FlyRay2025-gif/stm32-env-thermometer/docs/实验方案（实施版）.md

# 基于单片机的环境温度测量仪 —— 实验方案与实施（实施版）

**项目名称：基于单片机的环境温度测量仪设计与制作**
**项目性质：校级开放性实验室项目（2026-09-01 ～ 2026-11-01）**
**成果形式：实物作品 + 结题报告**
**文档版本：V1.1（2026-10-10 按实际实施情况修订）｜本公开版已脱敏、仅保留技术内容**

*项目主要内容：为解决传统温度测量响应迟缓、精度不足等弊端，设计以32系列单片机为核心控制器，结合DS18B20、LM35等温度传感器及液晶显示、报警、按键设置等模块，通过C语言编写程序并优化数据精度，完成环境温度测量仪的设计与制作，实现环境温度的精准采集、实时显示、阈值报警，测量仪结构精简、成本可控*

***

## 0. 一页纸摘要

| 项 | 结论 |
| --- | --- |
| 主控 | **STM32F103C8T6**（ARM Cortex-M3，72 MHz，64 KB Flash / 20 KB RAM，LQFP-48 最小系统板"Blue Pill"） |
| 开发路线 | **Keil MDK5 + STM32F10x 标准外设库 V3.5.0**，同型号板卡、同库，教程例程（按键/串口/TIM-PWM/ADC+DMA/OLED/AT24C01/单总线 DS18B20）可直接复用 —— 这是 2 个月工期的主要保障（详见 5.0） |
| 数字温度通道 | **DS18B20**（1-Wire，12 位，0.0625 ℃ 分辨率）×1 只（模块版，板载 4.7 k 上拉） |
| 模拟温度通道 | **LM35DZ**（TO-92，10 mV/℃）**直接采样**：OUT→R9 100 Ω→PA4（无运放、无 C3）→ 片内 12 位 ADC |
| 显示 | **0.96″ OLED SSD1306（I²C，地址 0x3C）**；若老师要求"液晶"字样，直接换 **LCD1602A + PCF8574T（I²C 0x27）**，引脚不变 |
| 报警 | **3 针蜂鸣器模块**（VCC/GND/IO，自带驱动，TIM3 PWM）+ 红色 LED，单阈值、带回差 |
| 按键 | 3 × 6×6 轻触开关（SET / ＋ / －） |
| 参数存储 | **未安装**（AT24C02 预留未用；阈值仅存 RAM，断电回 30.0 ℃） |
| 上位机 | 板载 CH340（USART1，115200）输出 CSV，Excel 直接画图；可选 JY-89S 蓝牙 |
| 关键精度指标 | 分辨率 0.01 ℃（DS18B20）/ 0.1 ℃（LM35）；测温范围 **0～+80 ℃**（LM35 直采硬件 0～+100 ℃，负温段不可测）；综合精度目标 ≤ ±0.5 ℃（以结题实测为准）；采样周期 ≤1 s；报警响应 <2 s；连续运行 ≥48 h（拷机待做） |
| 精度优化手段（本版已实现） | ① DS18B20：上电预填充 5 点缓冲 + **5 点滑动平均**；② LM35：**16 次采样平均** + 239.5 周期长采样；③ DS18B20 **CRC8 校验**、报警 0.5 ℃ 回差；④ 后续可加：VREFINT 校正、过采样、软件标定（见 5.4） |
| 硬件实现路径 | **面包板整机一步到位（免焊接）**；立创 EDA 原理图仅作报告插图，不打样、不焊接 |
| 成本 | 全部器件自费，整机物料成本在 200 元以内（以实际采购为准） |
| 最大风险 | **面包板接触不良**（已实际发生：OLED 黑屏、电阻虚接、LM35 假读数）→ 免仪表排故法见第 9 节；交付前避免搬动整机 |

> **实施变更摘要（2026-10-10，V1.1）**——本版按最终实物修订，与 V1.0 的主要差异：
> 1. **搭建路线：全程面包板，免焊接**。放弃洞洞板 + 排母与立创 PCB 打样——操作简便、迭代快；团队成员焊接经验生疏，避免焊接返工拖期；验收不要求 PCB。
> 2. **模拟通道：取消 MCP6002 运放调理，LM35 直接采样进 PA4**（1→5V、3→GND、2→R9 100 Ω→PA4）。到货的 MCP6002 为 SOIC-8 贴片封装，无法直插面包板；直采链路更短、误差源与故障点更少。代价：**0 ℃ 以下无法测量**（单电源无偏置）。
> 3. **C3 100 nF 抗混叠电容未安装**（可选件，实测读数稳定；若出现抖动可加回 PA4↔GND）。
> 4. **单只 DS18B20**；蜂鸣器改 **3 针模块**（自带驱动，无 S8050）；按键 **3 个**（SET/＋/－）；**AT24C02 未安装**（阈值仅存 RAM，断电回 30.0 ℃）。
> 5. **供电与调试：USB 供电（5 V + CH340），ST-Link 仅接 SWDIO/SWCLK/GND**。
> 6. 固件按直采公式 `T = V / 0.01` 换算；DS18B20 5 点滑动平均、LM35 16 次采样平均；VREFINT 校正、软件标定与 EEPROM 存储未实施（列为后续优化）。

***

## 1. 项目概述与设计目标

### 1.1 选题要求拆解（对照项目"主要内容"）

| 选题原文要求 | 本方案落实 | 章节 |
| --- | --- | --- |
| 以 32 系列单片机为核心控制器 | STM32F103C8T6 | 3、4、5 |
| 结合 DS18B20、LM35 等温度传感器 | 双通道：DS18B20 数字通道 + LM35 模拟通道，互为校核 | 4.2、4.3 |
| 液晶显示 | SSD1306 OLED（默认）/ LCD1602（可选替换，同一 I²C 总线） | 4.4 |
| 报警 | 3 针蜂鸣器模块 + LED，单阈值报警、可设、带回差 | 4.6 |
| 按键设置 | 3 键（SET/＋/－）阈值设置 | 4.5 |
| C 语言编写程序并优化数据精度 | 5 点滑动平均 + 16 次采样平均 + CRC 校验与报警回差 | 5、6 |
| 环境温度精准采集、实时显示、阈值报警 | 约 1 s 采样/刷新、<2 s 报警 | 1.2 |
| 结构精简、成本可控 | 单 5 V 输入、板上 3.3 V、总器件 ≤ 25 种、整机 ≤ 220 元（全部自费） | 3、8 |

### 1.2 量化验收指标（结题时按此逐项演示/举证）

| 编号  | 指标 | 目标值 | 验证方法 |
| --- | --- | --- | --- |
| M1  | 测温范围 | **0 ～ +80 ℃**（原目标 −10～+80 ℃；本版直采无负温段，硬件 0～+100 ℃） | 冰水混合物 + 恒温热水浴（实验室直流稳压电源+电热杯） |
| M2  | 显示分辨率 | 0.01 ℃（DS18B20 通道）/ 0.1 ℃（LM35 通道） | 读数末位观察 + 串口 CSV |
| M3  | 综合精度 | **≤ ±0.5 ℃**（−10～+60 ℃，两点标定后） | 与标准水银温度计（实验室借用）5 点对比 |
| M4  | 重复性（稳定性） | 恒温点 σ ≤ 0.1 ℃（30 min，1 Hz 采样） | 冰水浴静置 30 min，Excel 求标准差 |
| M5  | 双通道一致性 | 未标定偏差 ≤ 1.0 ℃，标定后 ≤ 0.3 ℃ | 两探头并扎同置 |
| M6  | 采样与刷新 | 采样周期 ≤1 s，显示刷新 ≥2 Hz 不卡顿 | 秒表 + 串口时间戳 |
| M7  | 报警功能 | 越限 <2 s 动作，回差 0.5 ℃ 不误报，消音有效 | 设定阈值后温度阶跃 |
| M8  | 掉电保持 | 阈值/标定系数断电 10 次不丢失 | 拔电重启核对 |
| M9  | 连续运行 | ≥48 h 拷机无死机、无复位、无显示异常 | 串口日志计数 |
| M10 | 抗电源扰动 | VDDA 在 4.5～5.5 V 变化时读数漂移 ≤ 0.2 ℃ | 实验室直流稳压电源调压 + 示波器监测 |
| M11 | 探头故障自检 | 拔下 DS18B20 后 1 s 内显示 `ERR` 并自动切换 LM35 通道 | 拔插演示 |
| M12 | **响应时间（直接回应选题"响应迟缓"痛点）** | 裸探头 t63 ≤ 10 s；带探头护套 t63 ≤ 25 s；同时给出 DS18B20 与 LM35 两通道对比 | 阶跃法：两探头并扎，从室温迅速移入冰水，串口 20 Hz 记录，Excel/serialplot 求 63% 到达时间 |

> **注 1**：M3 与 M10 是答辩最能拉开差距的两条，务必留原始数据。
> **注 2**：M12 是选题"为解决传统温度测量响应**迟缓**、精度**不足**等弊端"中"响应迟缓"四项字要求里唯一需要**动态测试**的指标，务必与 M3 一起留图（阶跃曲线 + 标定散点＝报告两张核心图）。

> **实施版逐条状态（2026-10-10）**：M1 → 实际 0～+80 ℃（负温段不具备）；M2 已实现；M3 → 以结题实测比对为准（本版无软件标定）；M4 → 待测；M5 → 待测（两探头并扎）；M6 → 约 1 Hz 刷新（原目标 ≥2 Hz，实际为 1 s 一轮）；M7 已实现（0.5 ℃ 回差）；**M8 → 不适用**（未装 AT24C02，阈值断电回 30.0 ℃，作为已知限制）；M9 → 拷机待做；M10 → 不适用（USB 供电，无调压条件）；**M11 → 部分**（拔探头显示 DS18B20 ERROR，无自动切换）；M12 → 待测。

***

## 2. 方案论证（为什么这样选）

### 2.1 主控三条路线对比

| 路线 | 代表 | 优点 | 缺点 | 结论 |
| --- | --- | --- | --- | --- |
| A：8 位 | STC89C52 / STC12C5A60S2  | 资料最多、上手最快 | 无 12 位 ADC（LM35 需外挂 ADS1115）、无硬件 I²C 需软件模拟、精度上限低 | 否（与"32 系列"要求不符） |
| B：32 位国产 | CH32V003 / CKS32F103C8T6 | 便宜 | 生态与教程少，ADC 一致性资料不足 | 否（作为 B 计划备用） |
| **C：STM32F103C8T6** | 通用 Blue Pill | 内置 12 位 ADC + 温度传感器 + VREFINT + 硬件 I²C/USART/TIM；**（同型号板 + Keil MDK + 标准外设库），单总线 DS18B20、OLED、AT24C01、ADC、TIM-PWM、串口例程可逐章直接复用**；实验室示波器/仿真器通用 | 引脚多、需理解时钟树；标准库需自己配置寄存器（教程已覆盖） | **采用** | | | | |

**采用理由（写进报告）**：① 满足"32 系列"要求；② 片内 12 位 ADC 与 VREFINT 自检通道，使 LM35 通道无需外置 ADC，符合"结构精简、成本可控"；③ 团队正按（Keil MDK + 标准外设库）学习同一型号芯片，**开发路线零切换成本**，2 个月内可完成。

### 2.2 双传感器通道的必要性（本项目立论核心）

| 对比项  | DS18B20（数字） | LM35（模拟） |
| ---- | --- | --- |
| 接口 | 1-Wire，占用 1 个 GPIO | 需 ADC（本版直连，无调理） |
| 分辨率  | 0.0625 ℃（12 位，可设 9～12 位） | 受 ADC 分辨率限制（约 0.08 ℃/LSB） |
| 精度 | ±0.5 ℃（−10～+85 ℃） | ±0.5 ℃（+25 ℃ 典型），需标定 |
| 转换时间 | 12 位 750 ms | 即时（可 1 kS/s） |
| 优点 | 免标定、抗干扰、可多点总线 | 响应快、可高频采样、验证模拟链路设计能力 |
| 缺点 | 慢、假货多 | 量程受单电源限制（0 ℃ 以下不可测） |

→ **两路互为校核 + 故障切换**，正好把"优化数据精度"做成有对比、有数据、有图表的结题亮点。

**外部实测佐证（开源调研 2026-09-02，详见附录 D）**：

* **精度目标可达成**：`Cyclohexi/STM32-Smart-Thermometer`（MIT）在同型号 F103C8T6 + SSD1306 上，仅用**两点线性校准**即实测残差 **RMS ≈ 0.5 ℃** → 本方案 M3 的 ±0.5 ℃ 不是拍脑袋指标。本版以 **16 次采样平均 + 5 点滑动平均**实现基础降噪（VREFINT 反算、64 次过采样与多点最小二乘标定列为后续优化），指标仍保守写 ±0.5 ℃，避免答辩时被单点数据反问。

* **响应时间必须量化**：`Santocoyo/Comparison-of-sensitivity-of-temperature-sensors-LM35-and-DS18B20`（MIT）用**空气 / 冷水 / 热水三种介质的阶跃对比**证明 LM35 明显快于 DS18B20 —— 这正是选题要求中"响应迟缓"痛点的实测形态。故新增 **M12 响应时间**指标（见 1.2）与阶跃测试步骤（见 6.1 步 10），并把"两通道 t63 对比曲线"作为报告核心图之一。

### 2.3 系统框图

```
                         ┌────────────────────────────────────────────┐
   USB 5V ──────────────►│  Blue Pill：AMS1117-3.3 → 3.3V             │
   （供电 + 串口）         └───────────┬────────────────────────────────┘
                                     │
   ┌───────────┐  1-Wire(PA1)        │  STM32F103C8T6
   │ DS18B20×1 │─────────────────────►│  ┌────────────────────┐
   └───────────┘  （上拉在模块上）      │  │ 主循环 ~0.8 s 一轮  │
                       ┌───────────┐  │  │ 采样/滤波/报警/显示  │
   环境温场 ──────────►│  LM35DZ   │  │  └────────────────────┘
                       └─────┬─────┘  │
                             │10mV/℃  │
                    R9 100Ω  │         │
                       ┌─────▼─────┐   │
                       │  PA4/IN4  │───┘
                       └───────────┘

   其余：I²C1(PB6/PB7) → SSD1306 OLED 0x3C ｜ PB12/13/14 → 3 按键
         PA6 → 3 针蜂鸣器模块 ｜ PA7 → 报警 LED ｜ PC13 → 心跳灯
         USART1(PA9/PA10) → 板载 CH340 → PC ｜ SWD(PA13/PA14) → ST-Link（仅下载）
```

***

## 3. 器件选型清单（BOM，全部到型号）

### 3.1 核心器件

| &#x23; | 位号 | 型号 / 规格 | 封装 | 数量 | 参考单价(元) | 采购渠道 | 备注 / 替代料 | 套件 |
| --- | --- | --- | --- | -- | --- | --- | --- | ---- |
| 1 | U1 | **STM32F103C8T6** 最小系统板（Blue Pill，含 AMS1117-3.3、板载 CH340G/CP2102、复位与 8M 晶振） | LQFP48 板 | 1 | 15～22 | 淘宝"STM32F103C8T6 最小系统板" | 正点原子 Mini STM32（¥69，资料更全）；芯片若为 **CKS32F103C8T6（国产兼容）** 功能可用，但需在报告中如实注明。**若团队已有 ST-Link 可省；若担心调试中烧坏可加购 1 块备用（+15～22 元）** | ✓ |
| 2 | U2 | **DS18B20**（建议买 **模块版：板载 4.7 k 上拉 + 3P 排针**） | TO-92 / 模块 | 1（模块版） | 2～5 | 淘宝/立创商城 | 关键：**认准原装或立创商城自营**，假货实测偏差可达 1～2 ℃；替代 **DS18B20+（带 -40~125 更宽）** | |
| 3 | U3 | **LM35DZ/NOPB**（TI，TO-92，±0.5 @+25 ℃，10 mV/℃，4～30 V 供电） | TO-92 | 1 | 8～14 | **立创商城有现货**（LM35DZ/NOPB） | 若涨价/缺货：换 **LM35AZ** 或 **MF58 10 k B3950 NTC + 分压**（需重做标定，方案 4.3 电阻值另算） | |
| 4 | U4（未采用） | **MCP6002**（原计划运放调理） | SOIC-8 | 0 | 3～5 | 立创商城 | **本版未采用**：到货为 SOIC-8 无法直插面包板，模拟通道改直采（见 4.3） | |
| 5 | D1 | **0.96″ OLED SSD1306 128×64 I²C 4Pin** | 模块 | 1 | 12～16 | 淘宝 | 若需"液晶"：换 **LCD1602A + PCF8574T 转接板**（¥10，I²C 地址 0x27） | ✓ |
| 6 | U5（未安装） | **AT24C02** 模块（A0A1A2 接地 → 0x50） | 模块/SOIC | 1  | 2～4 | 淘宝/立创  | 亦可用 STM32 片内 Flash 模拟；**本版未安装、固件未含驱动**（阈值仅存 RAM） | |
| 7 | LS1 | **3 针蜂鸣器模块**（VCC/GND/IO，自带驱动；原计划为裸无源蜂鸣器） | 模块 | 1 | 1～3 | 淘宝/立创 | **本版实际使用 3 针模块**：无需 S8050 与基极电阻，IO 直连 PA6（2 kHz PWM 触发） | ✓ |
| 8 | Q1（未采用） | ~~S8050 三极管~~（原计划蜂鸣器驱动） | TO-92 | 0 | 0.1 | — | **本版未使用**：蜂鸣器为 3 针模块，自带驱动 | |
| 9 | SW1-3  | 轻触开关 6×6×5 mm 四脚 | 直插 | 3 | 0.1 | 元件包 | 本版使用 3 键（SET/＋/－） | ✓ |
| 10 | LED1-2 | 红色/绿色 3 mm LED | 直插 | 3  | 0.1 | 元件包 | — | ✓ |
| 11 | X1 | **8.000 MHz 无源晶振 HC-49S**（最小系统板已焊） | — | — | — | — | 教程模板默认用板载 HSE×9=72 MHz，无需改动；**若怀疑晶振不起振（上电卡死在时钟就绪等待），临时把 PLL 源改 HSI 降频验证**（见 5.1 降级手段） | |

> **实施版 BOM 说明**：本版实际使用 U1、DS18B20 模块×1、LM35DZ×1、OLED、3 针蜂鸣器模块、3 按键、LED、R9 100 Ω、杜邦线、830 孔面包板；U4/U5/Q1、排母、洞洞板、PCB、外壳等未采购或未使用。

### 3.2 阻容与结构件

| &#x23; | 名称 | 规格 | 数量 | 参考单价 | 套件 |
| --- | --- | --- | ----- | --- | ---- |
| 12 | 电阻 | 0805/1/4W 直插：4.7 k×10、10 k×20、30 k×6、15 k×4、1 k×10、100 Ω×6 | 各若干 | 元件包 ¥8 | |
| 13 | 电容 | 100 nF 瓷片×20、10 µF/25 V×10、1 µF×6、22 pF（板载） | 各若干 | 元件包 ¥8 | |
| 14 | 排针/排母 | 2.54 mm 单排 1×40 | 各 4 条 | ¥6 | 部分✓（套件含面包板跳线） |
| 15 | 杜邦线 | 母对母 20 cm ×40 | 1 排 | ¥5 | ✓ |
| 16 | 万能板/洞洞板 | 7×9 cm 单面 | 1 | ¥6 | |
| 17 | 面包板 | 830 孔 | 1 | ¥8 | ✓ |
| 18 | PCB | 立创 EDA 双层 10×10 cm 内，5 片 | 1 单 | **¥0（嘉立创 2026 年每月 2 张免费打样券，≤10×10 cm、最多 4 层、含运费，须通过 DRC、勿拼板）** | |
| 19 | 外壳 | 塑料仪表盒 120×80×45 mm 或 亚克力激光切割 | 1 | ¥15～35（可用 3D 打印/硬纸板/亚克力边角料替代，或直接裸板交付） | |
| 20 | 电源 | 5 V/2 A USB 电源适配器；或 18650 电池盒 + MT3608 升压（便携演示用） | 1 | ¥15～25（可用笔记本 USB 口供电，无需另购） | |
| 21 | 开关/保险 | 船型开关、500 mA 自恢复保险丝 | 各 1 | ¥3 | |
| 22 | 其他 | 排线、铜柱、杜邦头、热缩管、锡丝、助焊剂 | — | ¥20 | |

> **实施版**：实际只用 R9 100 Ω×1 与杜邦线/面包板；其余阻容（10k/30k/15k 等）与结构件未使用，焊接耗材未用。

### 3.3 工具与借用设备（不采购）

| 设备 | 用途 | 来源 |
| --- | --- | --- |
| ST-Link V2（或 J-Link OB） | 下载 + 在线调试 + DWT 微秒延时 | **套件已含**（三人共用，无需另购） |
| 数字示波器（≥50 MHz） | 观测 1-Wire 时序、I²C 波形、ADC 输入纹波、VDDA 稳定性 | **实验室开放实验条件**，预约使用 |
| 直流稳压电源 | 4.5～5.5 V 调压做电源调整率测试（M10） | 实验室 |
| 信号发生器 | 输出 0～1.5 V 精密直流/缓变斜坡，替代 LM35 标定 ADC 链路线性度 | 实验室 |
| 标准水银温度计 / 高精度数显温度计 | 标定与对比基准（M3） | 实验室借用（或自购 ¥25） |
| 万用表、电烙铁（可调温）、吸锡带、放大镜 | 焊接与排查 | 实验室 |

***

## 4. 硬件设计（到引脚、到电阻值）

### 4.1 主控最小系统 U1

* 直接用最小系统板：板上已含 STM32F103C8T6、8 MHz HSE、AMS1117-3.3、复位电路、BOOT0/BOOT1 跳线、板载 USB-TTL（CH340G，接 PA9/PA10）与 micro-USB。

* **上电前必查**：BOOT0 跳线接 GND（从 Flash 启动）。Blue Pill 常见"焊反 BOOT 排针导致无法启动"。

* **VDDA 处理**：板上 VDDA 与 VDD 已内部相连；额外在 VDDA 引脚附近加 **100 nF + 1 µF + 10 µF** 去耦（LM35 通道精度依赖它）。

* **PC13 心跳灯**：本版实际用 PC13 板载 LED 作 1 Hz 心跳指示，所用批次驱动正常；若遇驱动弱/闪烁异常，可改 PB0 外接 LED。

### 4.2 DS18B20 数字温度通道（1-Wire）

```
        3.3V ─────┬────── R1 4.7kΩ ──┐ (上拉，紧贴 DS18B20 端)
                  │                  │
   VDD(左)  ──────┘                  ├────── PA1 (GPIO 开漏/内部上拉)
   DQ (中)  ─────────────────────────┘        │
   GND(右)  ────── GND ───────────────────────┴──── GND
        │
   DS18B20 TO-92（字面朝自己，引脚从左至右：GND / DQ / VDD）
   ※ 若买模块版：模块上已有 4.7k 上拉，直接接 VCC/DQ/GND 三线
```

* **本版只装 1 只 DS18B20**（模块版，上拉在模块上）。驱动用 0xCC 跳过 ROM，仅支持单只；双探头冗余为后续扩展（需补 ROM 搜索/匹配）。

* 接线长度 ≤ 30 cm 用 4.7 kΩ；若探头延长到 1 m，上拉降到 **2.2 kΩ** 并用三芯线（VDD/GND/DQ），**严禁寄生供电**（VDD 悬空会导致 −7 ℃ 恒定读数）。

* 探头处加 **100 nF 到 GND**，长线串 **100 Ω**。

* **典型坑（写进报告的"调试记录"）**：

  1. 读到 `0x0550`（=85 ℃）→ 上电复位默认值，说明没做 Convert T，只读了暂存器；

  2. 读到 −7 ℃ / 恒定值 → 寄生供电或 VDD/GND 接反；

  3. 时序被中断打断 → 复位/写时隙必须**关中断 + 用 DWT 精确微秒延时**（教程 `Delay.c` 的 `Delay_us` 是按 72 MHz 标定的空循环，改优化等级或主频就会偏；且 SysTick 在 PRIMASK=1 时不计数 → 这是本项目最容易踩的坑）。

* **本版为阻塞式读取**：`StartConv` 后 `Delay_ms(760)` 再读暂存器（简单可靠，OLED 约 1 s 刷新一轮）；"非阻塞 + 期间刷新"列为后续优化。

* 每帧读 9 字节，做 **CRC8（多项式 x⁸+x⁵+x⁴+1，反射式 0x8C）** 校验，CRC 错则丢弃并计入错误率统计（报告可给"10 万帧 CRC 错误 0 次"的数据）。

### 4.3 LM35 直接采样通道（ADC1_IN4，本项目模拟通道）

**实际实施方案（V1.1）**：取消运放调理，LM35 输出经一只串联电阻直接进 ADC。

```
   LM35DZ（TO-92，平面朝自己、脚朝下：1 VCC / 2 OUT / 3 GND）
   1 ── 5V（USB 供电；LM35 需 4～30 V）
   3 ── GND
   2 ── R9 100 Ω ──┬── PA4（ADC1_IN4）
                   │
              （C3 100 nF 未装，可选）
```

* 换算：`T(℃) = V / 0.01`（10 mV/℃）；**0 ℃ 以下输出为负、单电源无法测量**，固件对负值按 0 处理。
* 量程：硬件 0～+100 ℃（ADC 0～1 V 段）；实际验收按 0～+80 ℃。
* 分辨率：3.3 V / 4095 ≈ **0.806 mV/LSB ≈ 0.08 ℃**；软件 **16 次采样平均**抑制噪声。
* 采样配置：ADC1_IN4，独立模式单次转换，**采样时间 239.5 cycles**（ADC 时钟 12 MHz，APB2/6）。
* 主要误差：LM35DZ 自身 ±0.5 ℃（25 ℃ 典型）、AMS1117 基准 ±1.5%（未做 VREFINT 校正）、面包板接触与走线干扰 → 结题以实测比对（冰水/室温/热水）为准。
* **为什么放弃运放（记录）**：原设计为 MCP6002 偏置放大（`Vout = 2·V_SEN + 0.4125 V`，可覆盖 −20～+135 ℃）。实际到货为 **SOIC-8 贴片封装**，无法直插面包板；且本版优先"操作简便、少一个故障点"，故改为直采。代价是失去负温段——M1 的 −10 ℃ 项实测不可达（测试手段也只有冰水/热水，产不出负温）。
* **备选方案（原设计，未实施，供后续 PCB/升级版参考）**：单级偏置同相放大，`Vout = 2.0·V_SEN + 0.4125 V`，`T = (Vout − 0.4125) / 0.02`。R3 15 k / R4 1 k 分压得 0.206 V 基准（U4A 跟随），R5 / R6 10 k 求和，U4B 增益 4（1 + R8 30 k / R7 10 k），R9 100 Ω + C3 100 nF 进 PA4。若后续换 PCB 或补直插运放，可恢复负温量程（接线见《B板模拟接线图》存档）。

### 4.4 显示模块 D1（SSD1306 I²C）

* 4 线：`VCC→3.3V`、`GND`、`SCL→PB6`、`SDA→PB7`。

* **总线方案：OLED 走教程的"软件模拟 I²C"驱动（PB6=SCL、PB7=SDA，GPIO 开漏/推挽 + 输入读）**。理由：① 教程 OLED 例程可直接复用；② STM32F103 硬件 I²C1 有已知 BUSY 位锁死 errata；③ 刷新量小，软 I²C 足够。AT24C02 本版未装。

* **I²C 上拉**：确认板上有 4.7～10 k 上拉；若无，PB6/PB7 各加 4.7 k 到 3.3 V（Blue Pill 多数批次无此上拉，**这是"屏幕不亮"的第一嫌疑**）。

* 地址：本版固定 **0x78（7 位 0x3C）**；0x3D 批次需改宏。

* 界面（128×64，分 4 行 + 状态栏）：

```
┌────────────────────────────┐
│ DS18B20:22.33C            │  ← 0.01 ℃
│ LM35:  22.3 C             │  ← 0.1 ℃
│ TH: 30.0 NORMAL           │  ← 阈值 + 状态（报警时 ALARM）
│ K1:SET K2:+ K3:-          │  ← 按键提示（设置时：SET TH: K2+ K3-）
└────────────────────────────┘
```

* 刷新策略：主循环每轮整屏刷新（约 1 Hz，无明显闪烁）；增量刷新列为后续优化。

* **若老师坚持"液晶显示"**：换 LCD1602A + PCF8574T（同为 I²C，总线不动，仅换驱动函数），显示 `T=25.43C  ALM:OFF` / `H:30.0 L: 5.0`。方案默认 OLED，理由：免对比度电位器调试、无字符偏位问题、省 1 小时调试时间。

### 4.5 按键（3 键，低有效）

```
 PB12 ── SW1(K1 SET) ── GND       内部上拉 40 kΩ
 PB13 ── SW2(K2 ＋)  ── GND       软件消抖：20 ms + 等待释放
 PB14 ── SW3(K3 －)  ── GND
```

| 键 | 功能 |
| --- | --- |
| K1  | 进入/退出阈值设置模式 |
| K2  | 设置模式下阈值 +0.5 ℃（范围 0.0～99.0） |
| K3  | 设置模式下阈值 −0.5 ℃ |

* 本版未加硬件消抖电容（100 nF），软件消抖实测足够。
* 原设计的第 4 键（消音/确认）与长按菜单未实施。

### 4.6 报警电路（3 针蜂鸣器模块 + LED）

```
 PA6 (TIM3_CH1, 2 kHz PWM) ── IO  ┐
 3.3V ────────────────────── VCC ├─ 3 针蜂鸣器模块（自带驱动）
 GND ─────────────────────── GND ┘
 PA7 ── R11 1kΩ ── LED1(红) 阳极 ── 阴极 ── GND
```

* **蜂鸣器为 3 针模块（VCC/GND/IO，自带驱动）**：无需 S8050 三极管与基极电阻（原设计的这部分已拆除）；其触发极性与 2 kHz PWM 恰好相合。
* 报警逻辑：DS18B20 滤波值 > 阈值 → 置位（TIM3 输出 + PA7 高电平）；低于"阈值 − 0.5 ℃"才解除（回差防抖，M7 判据）。
* 原设计的音调分级（预警/故障三短鸣）与消音键未实施。

### 4.7 通信与上位机

* **USART1 PA9(TX)/PA10(RX) → 板载 CH340 → micro-USB → PC**，115200 8N1，无需外接 USB-TTL。

* 输出格式（约 1 s 一行，串口助手/Excel 均可直接处理）：
  `序号,DS=22.33C,LM=22.3C,TH=30.0C,NORMAL`（报警时末段为 `ALARM`）

* 命令解析未实施（仅单向输出）。

* **PC 端工具直接用 serialplot（GitHub `hyOzd/serialplot`，1093★）**：实时多通道曲线 + CSV 落盘，比"串口助手复制→Excel 分列"快一个数量级，48 h 拷机与标定散点图可直接截图进报告。它是独立 PC 程序（GPL-3.0），不影响固件许可。详见附录 D.1。

* 蓝牙（JY-89S，USART2）为可选扩展，本版未实施。

### 4.8 参数存储（AT24C02，本版未安装）

> **本版未实施**：未安装 AT24C02，固件亦未包含其驱动；阈值仅保存在 RAM，**断电重启恢复默认 30.0 ℃**（M8 记为"不适用"）。以下为预留设计，供后续升级参考。

* 与 OLED 共用同一条 I²C 总线（PB6/PB7，软件模拟），靠从机地址区分：OLED `0x3C`、AT24C02 `0x50`。

* 存储结构（40 字节）：`magic(2)=0x5A17 | ver(1) | k_x10000(4,float32) | b_x1000(4) | TH_H(2,int16×10) | TH_L(2) | 回差(1) | 亮度(1) | 单位(1) | 采样周期(1) | 保留(15) | CRC16(2)`

* 写入策略：**只在"确认"键或参数变化后写**，避免 750 ms 循环擦写（EEPROM 寿命 100 万次，但仍应规范）。

* 三条防呆规范（吸收自 `Cyclohexi/STM32-Smart-Thermometer`，MIT，见附录 D.1）——把"能存"做成"存不坏"，答辩可直接作为软件工程规范讲：

  1. **写前合理性校验**：任一参数越界即拒绝写入并在 OLED 提示 `ERR`（k 限定 0.80～1.25、b 限定 ±5.0 ℃、TH-H/TH-L 限定 −20.0～+135.0 且强制 TH-H > TH-L + 回差）→ 防止误操作把标定系数写成垃圾值后"再也读不回来"。

  2. **3 s 防抖**：两次 EEPROM 写入的最小间隔 3 s（用 TIM2 时基记时间戳），期间再次按"确认"只更新 RAM 不擦写 → 避免连按导致同一页反复擦写。

  3. **上电三重判定**：`magic` + `ver` + `CRC16` **任一不符**即用默认参数表（附录 B）覆盖 RAM 并回写一次 EEPROM，同时在串口日志记一条 `EEPROM_REINIT` → 保证"参数丢不了、板子换得不怕"。

### 4.9 电源与下载

```
 USB 线 → Blue Pill（板载 AMS1117-3.3）
          ├─ 5V → LM35 VCC（LM35 必须 5V）
          ├─ 3.3V → OLED、蜂鸣器模块（3.3V 规格）、各上拉
          └─ CH340 → USART1（115200，CSV 输出）
 ST-Link V2：仅接 SWDIO / SWCLK / GND（下载调试；不接 3.3V）
 GND：全板单点共地（电源地 → 主控地 → 传感器地）
```

* 整机由 **USB 供电**（USB 兼供 5 V 与 CH340 串口），无需外部电源适配器。
* 下载走 ST-Link（3 根线）；**不要同时用 ST-Link 的 3.3 V 与 USB 供电**。
* 电池、保险丝、船型开关未实施（便携演示为后续项）。

### 4.10 完整引脚分配表（STM32F103C8T6，LQFP48 / Blue Pill）

| 引脚 | 功能 | 外设/模式 | 外部器件 | 备注 |
| --- | --- | --- | --- | --- |
| PA1 | DS18B20 1-Wire 总线 | GPIO 开漏 + 上拉（模块自带） | U2（模块） | 单只，0xCC 跳过 ROM |
| PA2 | 未使用（蓝牙预留） | — | — | 本版不接蓝牙 |
| PA3 | 未使用（蓝牙预留） | — | — | — |
| PA4 | LM35 输出（直采） | **ADC1_IN4** | R9 100 Ω（C3 未装） | 采样时间 239.5 cycles  |
| PA6 | 蜂鸣器 PWM | **TIM3_CH1** AF 推挽 | 3 针模块 IO | 2 kHz |
| PA7 | 报警 LED | GPIO 推挽 | R11 1k + LED | 高电平点亮 |
| PA9 | USART1_TX | AF 推挽 | 板载 CH340 | 115200 |
| PA10 | USART1_RX | 浮空输入 | 板载 CH340 | — |
| PA13 | SWDIO | 调试 | ST-Link | **不可占用** |
| PA14 | SWCLK | 调试 | ST-Link | **不可占用** |
| PB0 | 未使用 | — | — | 心跳灯实际用 PC13 |
| PB5 | 备用（预留第二路模拟/扩展） | GPIO | — | 备用 DS18B20 独立线 |
| PB6 | I²C SCL（软件模拟） | GPIO 开漏（教程 OLED 例程同） | 模块自带 | 仅 OLED |
| PB7 | I²C SDA（软件模拟） | GPIO 开漏 + 输入读 | 模块自带 | 仅 OLED |
| PB12 | KEY_SET (K1) | 上拉输入 | — | 低有效 |
| PB13 | KEY_UP (K2 ＋) | 上拉输入 | — | 低有效 |
| PB14 | KEY_DOWN (K3 －)  | 上拉输入 | — | 低有效 |
| PC13 | 心跳灯（板载 LED） | GPIO 推挽 | — | 1 Hz 翻转 |
| PA15/PB3/PB4 | **不使用** | — | — | JTAG/SWD 复用，避免误配 |
| ADC IN17 | 未使用（后续可做 VREFINT 校正） | — | — | 本版未用 |
| ADC IN16 | 未使用 | — | — | 后续可做自检 |

### 4.11 PCB / 装配要点（本版未实施，留作后续）

> **本版为面包板整机、免焊接**：未投板、未做洞洞板；以下要点供后续 PCB 版参考（原计划的运放、AT24C02 等需按 4.3/4.8 的备注调整）。

1. 尺寸控制在 **90×70 mm 内**（套嘉立创免费券，≤10×10 cm）。

2. 布局：LM35 与调理运放 **远离 STM32 与 DC-DC**（≥20 mm），单独"模拟岛"，模拟地与数字地单点连接。

3. 走线：ADC 输入线短、两侧包地（GND 守护线），下方完整地平面，禁止走时钟线/蜂鸣器 PWM 线交叉。

4. 8 MHz 晶振走线尽量短、包地、下方不掏地（用板载则免）。

5. 全部传感器/显示/按键用 **排针 + 杜邦线引出**，坏了能换（学生项目返修率主要在这里）。

6. 板上预留 **2 个测试焊盘**（VDDA、ADC_IN4）+ 1 个 UART 排针 → 结题答辩现场可测。

7. 装配顺序：先焊电源 → 测 3.3 V → 焊主控+排针 → 烧录心跳灯 → 逐模块插拔调试。**不要一次焊满**。

***

## 5. 软件设计

### 5.0 教程例程复用映射

> 本项目**刻意选与已学教程同平台、同库**，绝大多数底层驱动不用从零写，只需在其例程上改引脚与加业务逻辑。这也是"2 个月能做完"的底气所在。

| 教程章节（标准库） | 本项目直接用到 | 需要改动的地方 | 复用度 |
| --- | --- | --- | --- |
| GPIO / LED 输出 | PC13 心跳灯（板载）、PA7 报警 LED | 换引脚号 | 100% |
| 独立按键（含消抖） | 3 键 SET/＋/－（软件消抖） | 三键阈值设置；无长按/连加 | 85% |
| 串口通信 USART + printf 重定向 | 约 1 Hz CSV 行输出 | 波特率 115200、拼 CSV 行；无命令解析 | 90% |
| 通用定时器 TIM + 中断 | 未使用（TIM3 仅用于蜂鸣器 PWM） | — | — |
| TIM PWM 输出（蜂鸣器） | PA6/TIM3_CH1 报警音（2 kHz 固定） | 换通道、固定频率 | 95% |
| ADC 采集（未用 DMA） | PA4/IN4（LM35 直采）单通道轮询 | 采样时间 239.5 cycles、16 次平均 | 85% |
| 软件模拟 I²C + OLED（SSD1306） | 显示模块 | 画自定义 4 行界面 | 85% |
| I²C + AT24C01（软件模拟） | 未使用（AT24C02 未安装） | — | 0%（未实施） |
| **单总线 + DS18B20** | **本项目核心传感器通道** | 改引脚、CRC8 校验、阻塞式 750 ms 流程（单探头） | 75% | |
| 输入捕获 / 看门狗 / MPU6050 / FreeRTOS | 暂不使用 | — | 0%（**不要为炫技引入，时间优先**） |

**教程未覆盖、必须自研的两块（＝本项目的工作量与创新点，报告重点写这两处）**：

1. **LM35 直采链路与整机模拟接线**（硬件，见 4.3）：确认传感器供电/引脚、ADC 采样配置，并排查面包板接触类"假读数"（本项目实测两次：35.5 ℃ / 96 ℃ 均为 PA4 悬空假数），形成"短接法 / 飞线直连"的免仪表排故流程。

2. **数据采集与显示业务层**（软件，见 5.4）：主循环调度、DS18B20 5 点滑动平均、LM35 16 次采样平均、阈值回差报警、OLED 四行显示与串口 CSV。

> **兜底**：第 1 点里"非阻塞 1-Wire"这一最难子问题，GitHub 上有 MIT 授权的成熟实现（`a5021/stm32-async-1wire`，含 STM32F103C8T6 后端，见附录 D.1）。W3 若被时序问题卡住可直接引入，代价是让出 PA10 与 TIM1/DMA1_CH3-4——**先读它的移植约束再决定，不要盲目拷进工程**。

> **注意（唯一需要小心的地方）**：教程用**标准外设库（StdPeriph V3.5.0）**，网上另一批教程用 HAL/CubeMX，**两套代码不能混用**（函数名、初始化流程、工程结构都不同）。本项目全程走标准库，遇到 HAL 例程只当原理参考，不要复制函数。

### 5.1 开发环境（已具备，无需新增采购）

| 工具 | 版本要求 | 用途 |
| --- | --- | --- |
| Keil MDK-ARM (µVision5) | ≥5.36，已装（与教程一致） | 编译、调试、烧录 |
| **STM32F10x 标准外设库 V3.5.0**（教程配套固件库） | 已随教程获取 | Start/Library/System 三层工程骨架，直接套教程模板 |
| ST-Link Utility / STM32Cube Programmer | — | 下载、读出厂校准字（`0x1FFFF7xx`） |
| 串口助手（MobaXterm / SSCOM） | — | CSV 数据落盘 |
| Excel / Origin | — | 标定拟合、曲线图（直接进结题报告） |

> 时钟树：**直接沿用教程模板默认配置 —— 板载 8 MHz HSE ×9 = 72 MHz**（江协例程 `system_stm32f10x.c` 中 `SYSCLK_FREQ_72MHz` 即此配置）；APB2 = 72 MHz（ADC 时钟 = 72/6 = 12 MHz ≤ 14 MHz ✔）；APB1 = 36 MHz（TIM2/TIM3 定时器时钟 72 MHz ✔）。
> 降级手段：若怀疑晶振不起振（现象：`SystemInit()` 后卡死在 ` RCC_GetClocksFreq` 的 HSE 就绪等待），临时把 PLL 时钟源改为 HSI 降到 64 MHz 验证，再回头查晶振与负载电容 22 pF。

### 5.2 工程结构

```
环境温度测量仪/               ← Keil MDK5 工程（标准外设库 V3.5.0）
├─ Start/       CMSIS 头文件 + startup_stm32f10x_hd.s + system_stm32f10x.c（72 MHz）
├─ Library/     标准外设库 V3.5.0
├─ System/      Delay.c/h（教程延时，1-Wire 时序用）
├─ Hardware/    ★ 教程例程驱动（改引脚/业务后使用）
│   ├─ OLED.c        软件 I²C SSD1306（PB6/PB7）
│   ├─ DS18B20.c     单总线（0xCC 跳过 ROM + CRC8）
│   ├─ Key.c         3 键扫描（20 ms 消抖 + 等待释放）
│   ├─ Alarm.c       TIM3_CH1 PWM（2 kHz）+ PA7 LED + 0.5 ℃ 回差
│   └─ Uart.c        USART1 + printf 重定向（115200）
├─ User/        main.c（主循环：采样→滤波→报警→显示→串口→心跳）
└─ Project.uvprojx
```

### 5.3 主循环调度（前后台）

本版未使用 TIM2 时间片调度器与状态机，采用**主循环顺序执行**（前后台结构），一轮约 0.8 s：

| 步骤 | 内容 | 说明 |
| --- | --- | --- |
| 1 | DS18B20 StartConv | 启动 12 位转换 |
| 2 | Key_GetNum() | 等待转换期间扫描按键（20 ms 消抖） |
| 3 | Delay_ms(760) | 等转换完成 |
| 4 | DS18B20 读数 + CRC + 5 点滑动平均 | 失败则丢弃并打印 CRC error |
| 5 | LM35_GetTemp() | ADC 16 次平均 → `T = V/0.01`（负值按 0） |
| 6 | Alarm_Update(DS 滤波值, 阈值) | 0.5 ℃ 回差 |
| 7 | Display_Update() | OLED 四行刷新 |
| 8 | printf CSV 一行 | 约 1 Hz |
| 9 | PC13 心跳翻转 | 主循环存活指示 |

### 5.4 数据精度处理（报告"数据精度优化"章节正文）

**本版已实现**：

1. **DS18B20：5 点滑动平均**（上电用首次数值预填充缓冲，避免均值偏小）。

2. **DS18B20：CRC8 校验**，校验失败丢弃本帧（串口记 `CRC error`）。

3. **LM35：16 次 ADC 采样平均**（单次采样时间 239.5 cycles）。

4. **报警回差 0.5 ℃**，避免阈值附近抖动连响。

5. 显示分辨率：DS18B20 0.01 ℃、LM35 0.1 ℃。

**列为后续优化（未实施）**：中值滤波、一阶 IIR、64 次过采样、VREFINT 反算 VDDA、两点/最小二乘软件标定（需 AT24C02 或 Flash 存储系数）、双通道一致性判据与故障切换。原设计思路保留在本文档 V1.0 与附录 D 中，作为答辩"改进方向"素材。

### 5.5 关键代码片段（实际实现）

```c
/* LM35 直采：16 次采样平均 + 10 mV/℃ 换算（负值按 0 处理） */
static float LM35_GetTemp(void)
{
    uint32_t sum = 0;
    for (uint8_t i = 0; i < 16; i++) sum += LM35_ReadRaw();  /* ADC1_IN4, 239.5 cycles */
    float vin = (float)sum / 16.0f * 3.3f / 4095.0f;
    float t = vin / 0.010f;                                  /* 10 mV/℃ */
    return (t < 0.0f) ? 0.0f : t;
}

/* 主循环一轮（约 0.8 s）：采样→滤波→报警→显示→串口→心跳 */
DS18B20_StartConv();
key = Key_GetNum();                    /* 等待转换期间扫键 */
Delay_ms(760);
if (DS18B20_ReadTemp(&raw)) tempFiltered = Filter_Update(raw);
lm35Temp = LM35_GetTemp();
Alarm_Update(tempFiltered, threshold); /* 0.5 ℃ 回差 */
Display_Update(tempFiltered);
printf("%d,DS=%d.%02dC,LM=%d.%dC,TH=%d.%dC,%s\r\n", ...);
```

***

## 6. 标定与测试方案（利用实验室现有仪器）

### 6.1 比对与标定实验步骤

| 步 | 操作 | 记录 |
| -- | ---- | ---- |
| 1 | 碎冰 + 蒸馏水静置 15 min（0.0 ℃），两探头并扎入（不触杯壁） | 两通道 60 s 平均读数 |
| 2 | 室温自平衡（用标准水银温度计读 T_ref） | 同上 |
| 3 | 热水浴 30 / 40 / 55 ℃（电热杯 + 温度计监控） | 同上 |
| 4 | Excel 拟合 `T = k·V + b`，求 R² 与残差（离线存档，本版不写入固件） | 拟合图（进报告） |
| 5 | 48 h 拷机（每秒一行 CSV） | 连续曲线 + 丢帧/CRC 错误统计（M9） |
| 6 | **阶跃响应测试（M12）**：两探头**并扎同点**，稳定后迅速移入冰水（再做一次移入 40 ℃ 热水），串口 20 Hz 记录，serialplot 求 t63 | 一张图含 DS18B20 与 LM35 **两条 t63 曲线**（报告核心图） |

> **实施版说明**：本版固件使用固定换算公式（无软件标定系数、无 EEPROM），步骤 4 的拟合结果仅用于**误差分析**，不改变实机读数；"写标定系数"为后续升级项（需先装 AT24C02 或使用片内 Flash）。信号发生器注入、稳压电源扫描（原步骤 6/7）本版未做——USB 供电无调压条件，ADC 线性度以冰水/室温/热水三点比对间接验证。

### 6.2 误差预算表（结题报告必放，体现"分析能力"）

| 误差源 | DS18B20 通道 | LM35 通道（本版，未标定） | 抑制措施 |
| --- | --- | --- | --- |
| 传感器固有精度 | ±0.50 | ±0.50（25 ℃ 典型） | 选正品；结题实测 |
| 量化/分辨率 | 0.0625 | ±0.081（≈0.806 mV/LSB） | 16 次平均 |
| ADC 噪声 | — | ±0.05（16 次平均后，估） | 长采样 + 平均 |
| 基准/电源（AMS1117，未校正） | 0（数字） | ±0.40（1.5% 基准偏差） | 后续 VREFINT 校正 |
| 运放失调/增益误差 | — | **0（无运放）** | — |
| 自热 | ±0.05 | ±0.10 | 间歇/通风 |
| 引线/接触 | ±0.10 | ±0.20（面包板） | 短引线、对折引脚 |
| **RSS 合成（估）** | **≈ ±0.52** | **≈ ±0.70** | — |
| **实测目标（M3）** | ≤ ±0.5 | 以结题实测为准（目标 ≤ ±1.0，未标定） | 与标准表比对 |

***

## 7. 开发过程（简要）

- 2026-09-01 立项，完成器件选型、采购与开发环境搭建；
- 9 月中下旬完成主控、OLED、串口、按键等基础模块验证；
- 9/28 起改为**面包板免焊接整机方案**（操作简便、迭代快，也规避焊接返工风险）；
- 10 月上旬完成 DS18B20 与 LM35 双通道采集、报警/按键/串口联动，LM35 直采通道调通；
- 10 月中下旬进行指标测试、稳定性拷机与结题材料整理。

## 8. 成本概要

全部器件自费，整机物料成本在 200 元以内（以实际采购为准）；未打 PCB、未使用运放与 EEPROM。

## 9. 风险分析与应对（含降级预案）

| &#x23; | 风险 | 概率 | 影响 | 应对 / 触发信号 |
| --- | --- | -- | -- | --- |
| R1 | **DS18B20 假货**（读数偏差 1～2 ℃、转换时间不准） | 高  | 高  | 立创商城自营或原装；到货即用冰水验证，偏差 >1 ℃ 立即换货（W1 买 5 只留冗余） |
| R2 | **LM35 缺货/涨价** | 中 | 高 | W1 首批下单；若断供 → 换 **LM35AZ** 或 **NTC MF58 + 分压**（改 4.3 电阻并重标定）；最后手段：LM35 通道改为"第二只 DS18B20"，报告如实说明并保留运放调理电路设计（作为设计验证性实验） | | | |
| R3 | 面包板接触不良导致"软件 bug"假象 | 高  | 中  | 关键信号一律用排针+焊好杜邦线；示波器先看波形再查代码 |
| R4 | 1-Wire 时序被中断打断 / 教程 `Delay_us` 空循环不准 | 高  | 高  | 强制使用 **DWT 微秒延时 + 关中断保护**（5.5 代码）；示波器实测时隙宽度再定版 |
| R5 | ADC 读数偏低/抖动 | 中  | 中  | 采样时间 239.5 cycles；接线/接触检查；必要时加 C3 100 nF |
| R6 | OLED 不亮（软件 I²C 时序过快 / 无上拉 / 地址不符） | 中  | 中  | 检查 PB6/PB7 的 4.7k 上拉；软件 I²C 每步延时 ≥1 µs（先按 100 kHz 等效速率跑通再提速）；地址 0x3C/0x3D 自动探测；用示波器看 SCL/SDA 波形定位 |
| R7 | PCB 打样失败/首版有错 | 中  | 高  | 免费券每月 2 张 → 允许一次改版；同时 **洞洞板备份机**（W4 就做），保证实物一定能交付 |
| R8 | 时间不足（假期/课程冲突） | 中  | 高  | **降级预案（按优先级砍）**：① 去掉蓝牙与片内温度自检；② 去掉 PCB，只交洞洞板整机（外观扣分但功能完整）；③ 阈值报警降为固定阈值；④ 保底交付 = 双 DS18B20 + OLED + 按键 + 蜂鸣器 + 串口数据，M1–M9 仍全部可达 |
| R9 | 报告数据不足 | 低  | 高  | W6/W7 就把 CSV 全部留存（Excel 画图），不要等 W8 补测 |
| R10 | 与"液晶显示"表述不符 | 低  | 低  | 备 LCD1602A + PCF8574T（¥10），换装 30 min |
| R11 | **教程进度未定**（仍在跟江协科技入门教程，ADC/单总线等章节可能未学到） | 高  | 中  | ① 排课与项目同频：W1 前看完"定时器 + ADC + I²C/OLED"，单总线章节正好在本项目核心需求上，可边学边用；② **先做教程已覆盖的模块**（LED/按键/串口/OLED/蜂鸣器，W1 内全部点亮），LM35 与单总线排 W2；③ **严禁混用 HAL 版例程、严禁引入 FreeRTOS/触摸按键等未学内容**，遇阻超过 2 小时就回教程例程逐行比对；④ 兜底：若 W3 末 LM35 通道仍未通，按 R8 降级为双 DS18B20 方案，功能与指标 M1–M9 仍可达 | | | |

> **实施版回溯（2026-10-10）**：R3（面包板接触）实际发生多次——OLED 黑屏=模块插错列、报警 LED/电阻虚接、LM35 两次假读数（35.5 ℃ / 96 ℃ = PA4 悬空，三飞线直连后恢复正常）；均按"短接法 / 逐段飞线"定位，已记入调试记录。R7（PCB）未发生（未投板）。其余按预案应对。

***

## 10. 交付物

- 实物作品：STM32F103 面包板整机（DS18B20 + LM35 双通道、OLED、按键、报警、串口）；
- 源码：Keil MDK5 工程（标准外设库 V3.5.0）；
- 文档：本方案与实施文档、接线图（PNG/SVG）；
- 数据：双通道一致性、冰水/热水比对与拷机记录（结题时补充）。

***

## 附录 A：整机接线总表（面包板实施版，照此连线即可）

| 从 | 到 | 线/元件 |
| -- | -- | --- |
| Blue Pill 5V | LM35 引脚 1（VCC） | 杜邦线（LM35 必须 5V） |
| LM35 引脚 3（GND） | GND 轨 | — |
| LM35 引脚 2（OUT） | **R9 100 Ω** → **PA4** | C3 100 nF 未装（可选） |
| 3.3V | DS18B20 模块 VCC；DQ→**PA1**；GND→GND | 模块自带 4.7 k 上拉 |
| 3.3V | OLED VCC；GND→GND；**PB6→SCL、PB7→SDA** | 模块自带排针 |
| **PA6** | 3 针蜂鸣器模块 **IO** | VCC→3.3V、GND→GND（模块自带驱动） |
| **PA7** | 1 kΩ → LED 正极（长脚），负极→GND | — |
| **PB12 / PB13 / PB14** | K1 / K2(＋) / K3(−) 各一键到 GND | 内部上拉，无外接电容 |
| **PC13** | 板载 LED（心跳） | 无需接线 |
| **PA13 / PA14** | ST-Link SWDIO / SWCLK + GND | 下载调试（不接 3.3V） |
| **PA9 / PA10** | 板载 CH340（USB） | 115200 |

## 附录 B：默认参数

| 参数 | 默认值 |
| --- | --- |
| 报警阈值 | 30.0 ℃（可设 0.0～99.0，步进 0.5） |
| 回差 | 0.5 ℃ |
| 采样/刷新 | 约 0.8 s 一轮（DS18B20 12 位 + LM35 16 次平均） |
| 显示 | DS18B20 0.01 ℃ / LM35 0.1 ℃ |
| 串口 | 115200 8N1，约 1 Hz，`序号,DS=xx.xxC,LM=x.xC,TH=xx.xC,NORMAL/ALARM` |
| 参数保存 | 无（未装 AT24C02，断电回默认 30.0） |
| I²C | 软件模拟（PB6/PB7），OLED 地址 0x78 |

## 附录 C：参考中文资料

1. **江协科技《STM32 入门教程-2023 版》（B 站）+ 配套标准库例程** —— 本项目 GPIO/按键/串口/TIM-PWM/ADC+DMA/软件 I²C OLED/AT24C01/单总线 DS18B20 各模块的底层驱动直接取自该教程，**只用其标准外设库版本，不要混用网上 HAL 版代码**

2. DS18B20 / LM35 / SSD1306 / AT24C02 数据手册（中文翻译版，立创商城器件页可下载）

3. 补充参考：《STM32F1 开发指南》正点原子、《STM32 库开发实战指南》野火（同为标准库版本，遇到教程未讲的 ADC 采样时间、VREFINT 校准章节时查这两本）

4. ST 官方：`STM32F103xx 中文参考手册（RM0008）`、`STM32F10x 标准外设库固件包 V3.5.0`（ADC 采样时间与出厂校准字章节）

5. 嘉立创/立创 EDA 官方教程：免费打样规则（2026 年：每月 2 张券，≤10×10 cm、最多 4 层、含运费、须过 DRC、勿拼板）

## 附录 D：可复用开源项目调研（GitHub，2026-09-02 检索）

> 检索结论（两轮：第一轮按学习路线/江协，第二轮按本项目关键词 DS18B20 / LM35 / SSD1306 / AT24C02 / 温控）：**没有找到可以"整包拿来直接结题"的同题开源项目** —— 早先发现的几个功能最接近的项目全部**没有 LICENSE**（法律上默认保留所有权利），且都不含 LM35 模拟链路与精度标定。但累计找到 **6 项真正值得用的部件**，其中含许可干净、可直接引用的实现。
>
> 第二轮两项关键收获，均已落进正文：
>
> * **`Cyclohexi/STM32-Smart-Thermometer`（MIT）** —— 全库中功能与本项目重合度最高且**许可干净**的同题项目，其"两点线性校准 RMS ≈ 0.5 ℃"实测为 M3 提供了外部依据（→ 2.2），其 EEPROM 防呆设计被吸收进存储策略（→ 4.8）。
>
> * **`Santocoyo/...LM35-and-DS18B20`（MIT）** —— LM35 与 DS18B20 灵敏度/响应速度对比实证，直接暴露出原方案指标表缺"响应时间"（→ 新增 M12 与 6.1 步 10）。

### D.1 推荐采用（许可干净）

| 仓库 | ★ / 最近推送 | 许可 | 对本项目的价值 | 采用建议 |
| --- | --- | --- | --- | ---- |
| **Cyclohexi/STM32-Smart-Thermometer** | 新入库 / 2026 | **MIT**（⚠ API 误报 `NOASSERTION`，已读 raw `LICENSE` 文件核实为 MIT，**查许可必须看文件不能只看 API 字段**） | **功能重合度最高的同题项目**：F103C8T6(Blue Pill) + SSD1306（软件 I²C，**同样用 PB6/PB7**）+ 中值滤波 + 滑动平均 + 两点线性校准（实测 **RMS ≈ 0.5 ℃**）+ 双阈值声光报警（0～80 ℃，步进 0.1）+ 阈值写 Flash 末页（带校验和 + **合理性校验** + **3 s 防抖**）+ OLED **增量刷新**避免整屏闪烁 + **仓库内含嘉立创 EDA `.epro` 原理图可下载** | ① 它的 RMS 0.5 ℃ 是我们 M3 指标的外部依据（→ 2.2）；② 它的 EEPROM/Flash 防呆三件套已吸收进 4.8；③ OLED 增量刷新是 W4 若出现"刷屏闪烁"的直接解法；④ `.epro` 原理图可作**嘉立创投板前的 DRC 对照**。**但它是 FreeRTOS + C++17 + CubeMX/HAL 栈 → 与本方案标准库路线不同栈，只借鉴设计细节，禁止移植代码**（见 5.0、R11） | | | | |
| **Santocoyo/Comparison-of-sensitivity-of-temperature-sensors-LM35-and-DS18B20** | — / 2024 | **MIT** | LM35 与 DS18B20 在**空气 / 冷水 / 热水**三种介质下的灵敏度与响应速度**对比实验**，实验设计与图表形式正是选题"响应迟缓"痛点所需 | **作为 M12 阶跃测试的方法模板**（→ 6.1 步 10）与报告"双通道对比"章节的图表范式；该工作为 **Arduino 平台**，只借实验方法与结论形式，不借代码 | | | | |
| **a5021/stm32-async-1wire** | 11 / **2026-09-02（当天仍在更新）** | **MIT** | **非阻塞 1-Wire + DS18B20 驱动**：用 TIM1+DMA 由硬件产生时隙，CPU 零等待、零中断；自带 CRC8、Search ROM、Alarm Search、按分辨率自动计算转换等待、多探头并行转换、**寄生供电检测**；README 明确提供 **STM32F103C8T6（Blue Pill）后端** | 本项目最难的软件点已被解决。**但不要 W1 就移植**：W2 先用教程阻塞版把传感器读通，W3 若 OLED 卡顿或时序不稳再引入。引入代价必须清楚：它的 F1 后端**硬绑 PA10（TIM1_CH3）+ TIM1 + DMA1_CH3/CH4** → ① 1-Wire 从 PA1 改到 PA10；② USART1 改为**只发不收**（PA9 TX 输出 CSV 够用，命令解析放弃或挪 USART2/PA2-PA3）；③ ADC 的 DMA 用 DMA1_CH1，与它不冲突；④ 必须保证 APB2 预分频 =1（我们本就 72 MHz，满足）。纯寄存器写法，可与标准库工程共存，但**同一外设不要两套库混配** | | | | |
| **hyOzd/serialplot** | **1093** / 2025-05 | GPL-3.0（PC 端工具，不传染固件） | 串口数据**实时曲线 + CSV 落盘 + 多通道自动分列** | **W2 起就用它替代"串口助手 + Excel 手抄"**：48 h 拷机曲线、标定散点、双通道对比图直接出图截图进报告。本次调研性价比最高的一项，预计节省工时 ≥6 h | | | | |
| **q-sharafian/STM32_AT24C02** | 3 / 2017 | **MIT** | **STM32F10x 标准库**的 AT24C02 驱动，与本项目同库 | 对照它检查页写（8 字节页）与写周期 5 ms 等待的实现，避免 EEPROM 写丢参数  | | | |
| **Awesome-Embedded-Learning-Studio/BareMetal-Drivers** | 6 / 2026-02 | **MIT** | 含 **F103 软件 I²C（`iic_f103.c`）+ SSD13xx OLED + UART logger + F1 时钟初始化** | 软件 I²C 的第二个参考实现；若 OLED 时序不稳，与教程 `si2c` 逐行比对定位 | | | |
| alexeychurchill/Thermometer | 1 / 2021-07-14 | **MIT** | 纯 C 的 **F103C8T6 + DS18B20 极简温度计固件**，与本项目同芯片、同传感器、无框架包装 | 适合当"读码顺序示范"（最小可读的 DS18B20 整机代码，比教程例程更接近成品）。**边界**：无 OLED、无 ADC、无标定、无滤波，功能面远窄于本项目，**不能当模板工程**，仅在其上理解数据流即可 | | |

### D.2 只读思路、不得拷码（无 LICENSE 或 GPL）

| 仓库 | ★ / 最近推送 | 为什么值得看 | 边界 |
| --- | --- | --- | --- |
| Kaleido05/STM32-Temperature-Detection-System-**StandardLib**-Version | 0 / 2026-08-06 | **同题且同库**：F103C8T6 + DS18B20 + OLED + BLE 遥控报警；目录就是 `Start/Library/System/User`，`System/` 下正是 `delay.c / ds18b20.c / oled_simple.c / si2c.c（软件 I²C）/ usart.c / app.h` | **印证本报告 5.2 的工程结构与"软件 I²C 优先"的选择是对的**；无 LICENSE → 只看结构与引脚分配思路，不拷代码 | | | |
| jiayu-here/TemperatureInspector_STM32F103C8T6 | 1 / 2026-07  | F103C8T6 + DS18B20 + PT100 + OLED + **MicroSD 记录** + 串口报警，功能面比本项目更宽 | 无 LICENSE；SD 卡记录是它的加分点，我们**不做**（会挤掉标定与拷机工时） | |
| 1409146772/PID_temperature_control | 13 / 2025-11 | DS18B20 + OLED + 串口 + **PID 控温**（恒温杯垫），★ 数最高的同题项目 | 无 LICENSE；**列为二期方向**：若老师要求"再加难度"，由"测量"升级为"控温"（PID + 加热片）是最省力的扩展路径  | |
| waitingformoon0423/TemperatureMonitor_STM32 | 2 / 2025-07  | **MIT**；DS18B20 + OLED + 蓝牙 + 阈值报警 + 历史记录，功能与本项目重合度最高 | 基于正点原子 **ZET6（HAL 库）** → 与本方案标准库路线不同库，仅参考其报警与界面逻辑 | |
| wajatimur/stm32f10x-stdperiph-lib | 48 / 2017 | 标准库 V3.5.0 固件包镜像 | 教程网盘失效时的备用下载源 |
| vtx22/STM32-DS18B20 | 8 / 2024-04  | C++ 库形式的 DS18B20 驱动，类封装思路清晰 | **无 LICENSE**（默认保留权利）；只读其类封装与错误码设计，**不拷代码** |
| FilipImre/OneWire | 1 / 2026-03  | **C 语言 bit-bang OneWire 库**，位级时序实现完整 | **GPL-3.0** → 只读其位级时序实现思路，**禁止拷码**（GPL 传染固件） | |
| fedebarrilete/stm32f103_ds18b20_modbus | 8 / 2023-08  | DS18B20 数据采集 + **Modbus-TCP 服务器**，是"测量 → 工业通信"的典型做法 | **GPL-3.0**；列为**二期/工业做法**参考，展示测量向工业通信的扩展路径，**本项目不做**（与 2 个月工期冲突） | |

### D.3 明确不采用（避免踩坑）

* **ARM-software/CMSIS-DSP**（1076★，Apache-2.0）：均值/中值/FIR/IIR 的标准实现。算法正确，但为一个 250 行的滤波器引入整个 DSP 库（编译配置、内存段、依赖）不值得。**结题报告里改为引用它来论证"本方案滤波链与业界标准实现一致"**，比使用它更能加分。

* **任何 HAL/CubeMX 版温度计数显项目**（含江协教程的第三方 HAL 移植版，如 OceanCing/I2C_OLED-HAL_Version、Tracker647/JiangKeDaHAL）：与本方案不同库，**只当原理参考，禁止复制函数**（见 5.0 注意事项）。

* **FreeRTOS / 触摸按键 / WiFi 上传**类扩展：与 2 个月工期冲突，见 R8、R11。

### D.4 许可与学术规范（写进报告"参考资料"的规矩）

1. **无 LICENSE ≠ 可自由使用**：GitHub 仓库默认"保留所有权利"，把无许可代码整段拷进提交物属学术规范风险 → 一律只读思路。

2. **MIT / Apache-2.0 可用**，但必须①保留原版权声明，②在报告"参考资料"写明**具体文件与作者**，③在源码文件头注明出处与改动点。

3. **GPL 的 PC 端工具（serialplot）不影响固件许可**（独立进程、无代码链接）；但绝不能把 GPL 代码拷进单片机工程。

4. 报告里主动写一节 **"自研 / 复用清单"**：自研＝LM35 直采链路与整机接线、采集/显示/报警业务层、面包板结构与调试记录；复用＝江协教程底层驱动 + 附录 D.1 的 MIT 部件。**评审老师最反感"整份网抄"，最认可"引用规范 + 自研比例明确"。**

### D.5 检索方法（可复现）

```bash
# 未认证也可用（约 60 次/小时）；中文关键词会被 GitHub 搜索 API 拒绝（unprocessable），
# 搜江协相关请用英文名 JiangKeDa
curl -sG https://api.github.com/search/repositories \
  -H "Accept: application/vnd.github+json" \
  --data-urlencode "q=STM32 DS18B20 OLED temperature" \
  --data-urlencode "sort=stars" --data-urlencode "order=desc" --data-urlencode "per_page=10"

# 查许可与最近更新时间（决定"能不能用"和"还活不活"）
curl -s https://api.github.com/repos/<owner>/<repo> | grep -E "license|pushed_at|stargazers"
```

**有效检索词组合**（两轮累计，按产出价值排序）：

* 第一轮（按学习路线/江协）：`STM32 DS18B20 OLED temperature`、`STM32 LM35 ADC temperature`、`JiangKeDa STM32`、`STM32 DS18B20 non-blocking`、`SSD1306 STM32 driver I2C`、`at24c02 stm32`、`serialplot`。

* 第二轮（按本项目关键词）：`STM32 DS18B20 LM35`（双传感器对比）、`STM32 SSD1306 OLED software I2C`（显示驱动）、`at24c02 stm32 standard library`（EEPROM 同库驱动）、`temperature sensor comparison LM35 DS18B20 step response`（响应时间对比方法）、`STM32 temperature calibration`（标定）。

> **经验提示**：GitHub 搜索 API **不接受中文关键词**（会返回 `unprocessable` / `Validation Failed`），因此全部检索用英文；同义词 / 近义词替换（如 `non-blocking` ↔ `async`、`calibration` ↔ `calibrate`）比堆砌关键词有效。查许可必须读仓库内的 `LICENSE` 原始文件，**不能只看 API 返回的 `license.spdx_id` 字段**（Cyclohexi 即被误报为 `NOASSERTION`，已实测核实为 MIT）。

***

**结论（实施修订版）**：本版按"面包板整机、免焊接"完成实物：STM32F103C8T6 + 单只 DS18B20 + LM35 直采（无运放、无 C3）+ OLED + 3 键 + 蜂鸣器模块 + LED + 串口，数字与模拟通道均已实测跑通，硬件接线、固件与图纸三者一致。与原方案的偏差（面包板替代洞洞板与 PCB、取消运放与 C3、单探头、未装 AT24C02）已在上文逐处更新并说明原因；负温段不可测与阈值不保存已作为已知限制记录。剩余工作为指标测试、拷机与结题材料，**按 2026-11-01 节点完成可行**。开源侧已核实无"整包可用"项目，可复用件与许可边界见附录 D。

> **公开版说明**：本版本删除了项目编号、实验室房间号、经费预算与人员分工等非技术信息，技术内容与实物一致。
