FlyRay2025-gif/stm32-env-thermometer/B板模拟接线图.png

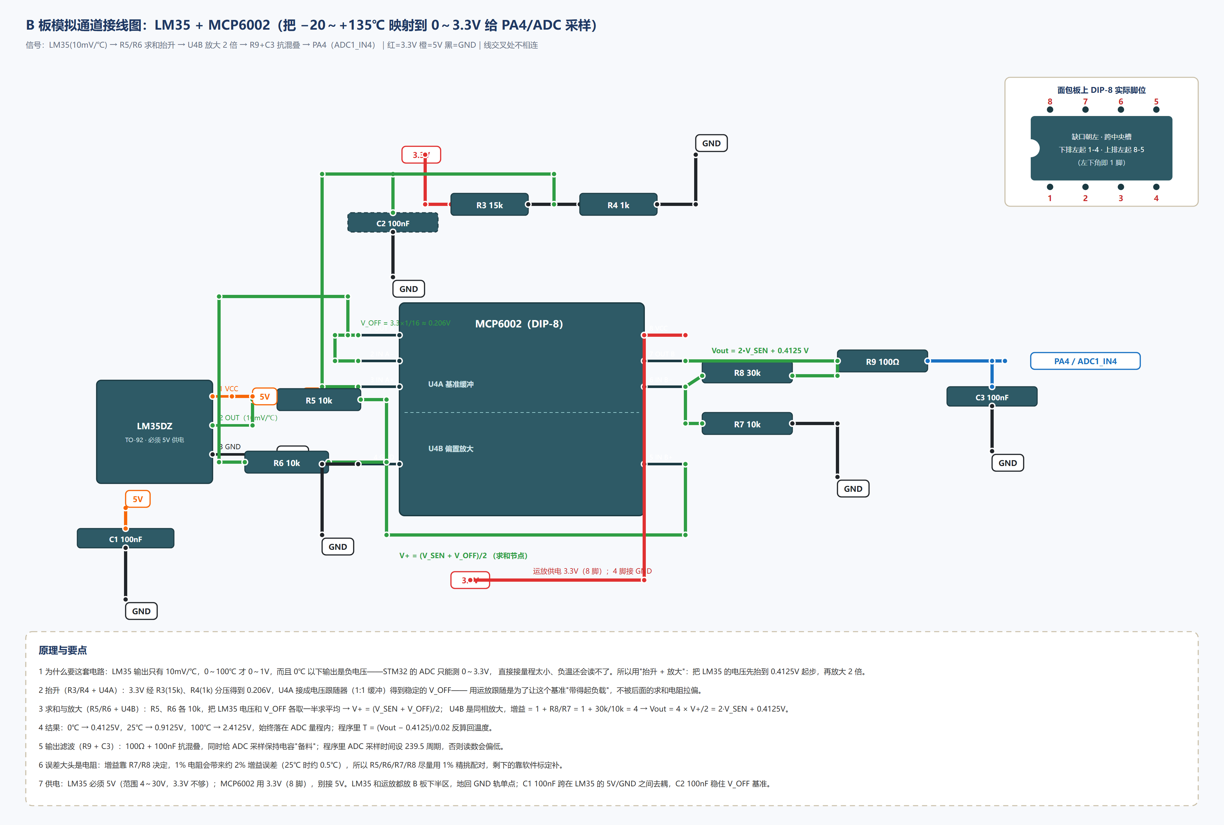
B板模拟接线图.png
