FlyRay2025-gif/stm32-env-thermometer/电阻接法示意.png

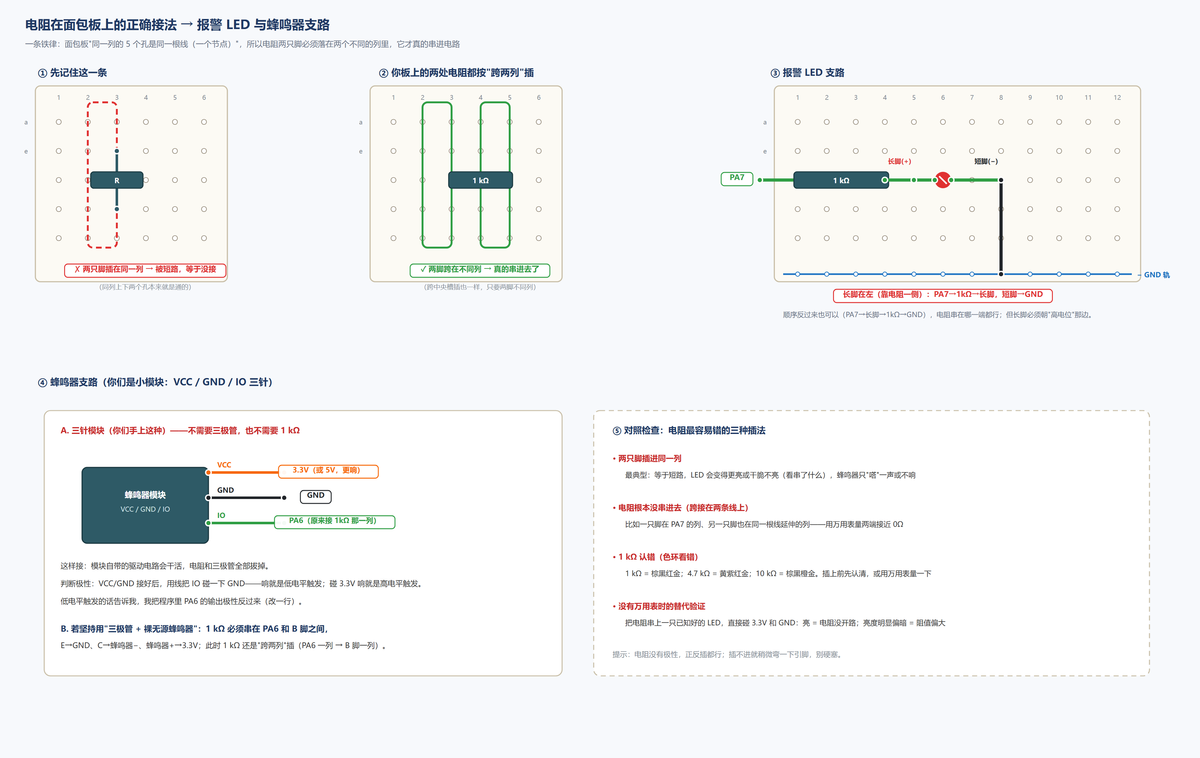
电阻接法示意.png
