FlyRay2025-gif/stm32-env-thermometer/面包板接线图.png

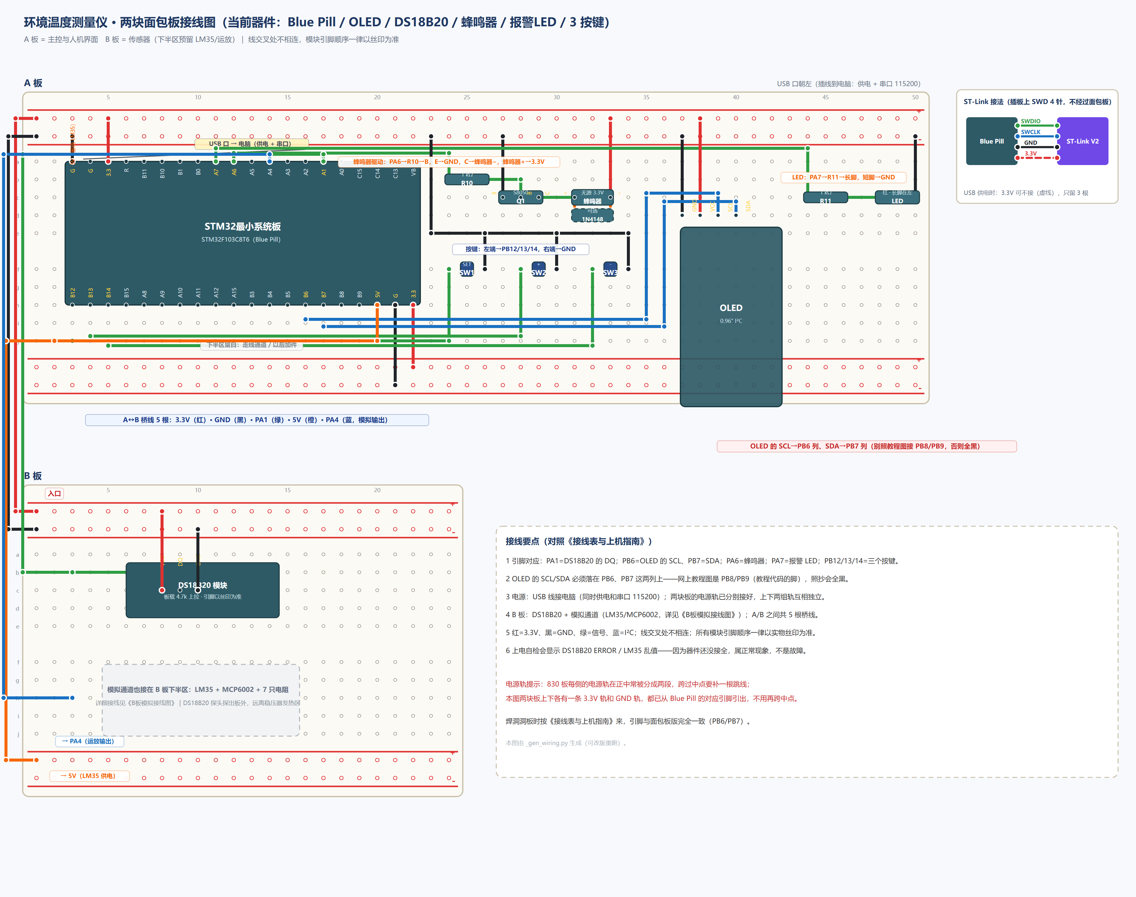
面包板接线图.png
