FlyRay2025-gif/stm32-env-thermometer/面包板版面图.png

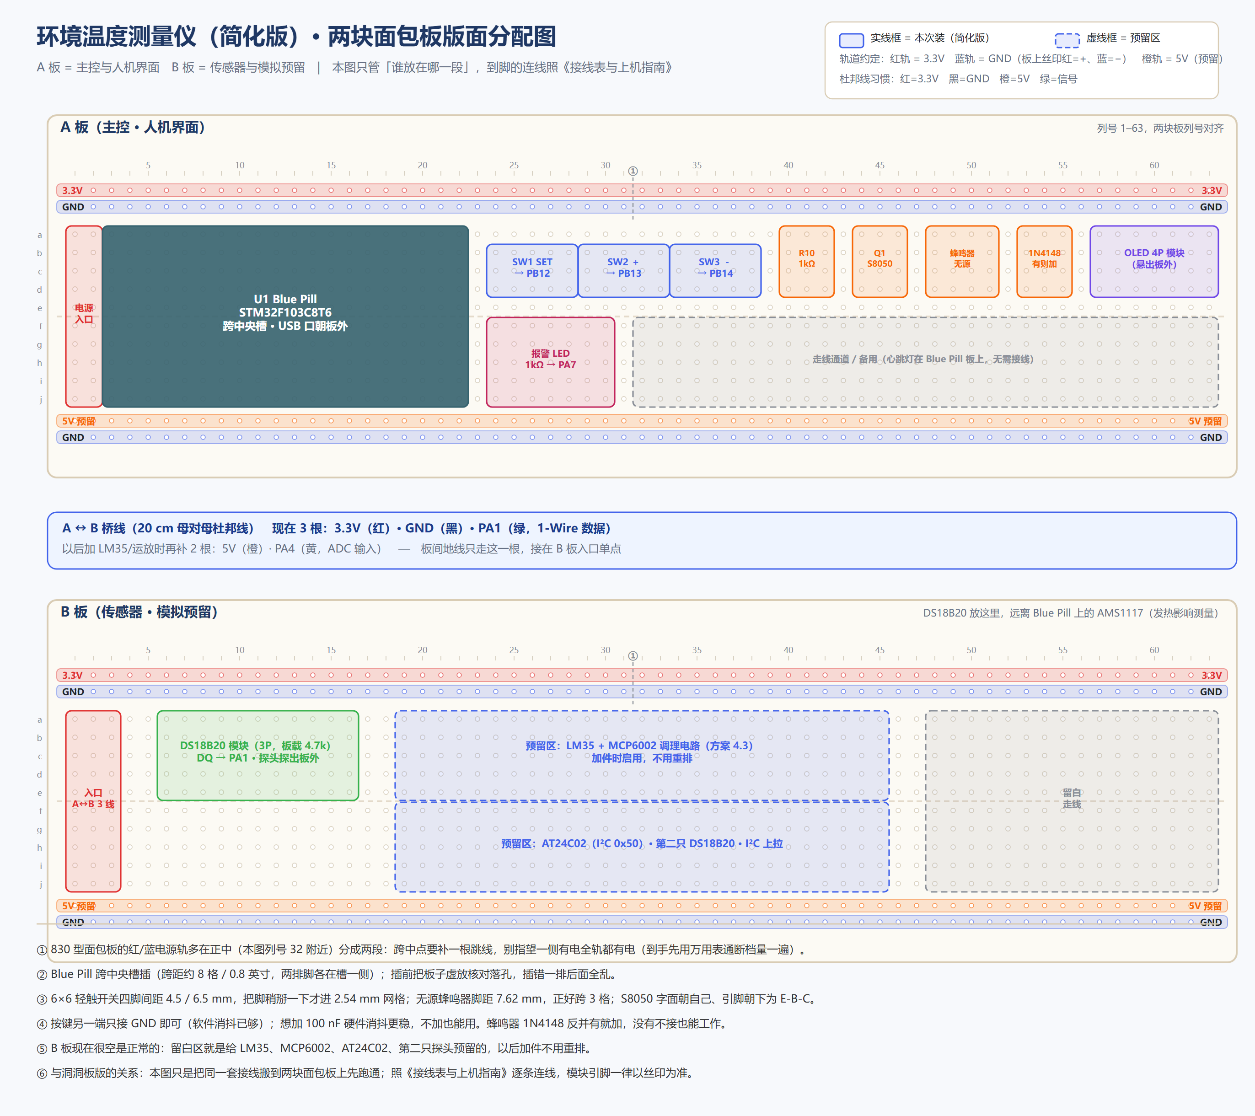
面包板版面图.png
