FlyRay2025-gif/stm32-env-thermometer/Hardware/Uart.c

 #include "stm32f10x.h"
#include <stdio.h>

/*=============================================================
 * 串口驱动（USART1：PA9 = TX / PA10 = RX）
 * 接板载 CH340 转 USB，波特率 115200-8-N-1
 * printf 已重定向到串口（需要在 Keil 中勾选 Use MicroLIB，
 * 本工程已通过工程设置开启）
 *=============================================================*/

/**
  * @brief  串口初始化
  */
void Uart_Init(void)
{
	GPIO_InitTypeDef GPIO_InitStructure;
	USART_InitTypeDef USART_InitStructure;

	RCC_APB2PeriphClockCmd(RCC_APB2Periph_GPIOA | RCC_APB2Periph_USART1, ENABLE);

	/* PA9：复用推挽输出（TX） */
	GPIO_InitStructure.GPIO_Mode = GPIO_Mode_AF_PP;
	GPIO_InitStructure.GPIO_Pin = GPIO_Pin_9;
	GPIO_InitStructure.GPIO_Speed = GPIO_Speed_50MHz;
	GPIO_Init(GPIOA, &GPIO_InitStructure);

	/* PA10：浮空输入（RX） */
	GPIO_InitStructure.GPIO_Mode = GPIO_Mode_IN_FLOATING;
	GPIO_InitStructure.GPIO_Pin = GPIO_Pin_10;
	GPIO_Init(GPIOA, &GPIO_InitStructure);

	USART_InitStructure.USART_BaudRate = 115200;
	USART_InitStructure.USART_WordLength = USART_WordLength_8b;
	USART_InitStructure.USART_StopBits = USART_StopBits_1;
	USART_InitStructure.USART_Parity = USART_Parity_No;
	USART_InitStructure.USART_HardwareFlowControl = USART_HardwareFlowControl_None;
	USART_InitStructure.USART_Mode = USART_Mode_Tx | USART_Mode_Rx;
	USART_Init(USART1, &USART_InitStructure);

	USART_Cmd(USART1, ENABLE);
}

/**
  * @brief  printf 重定向：Printf 输出字符时自动调用本函数发送到串口
  */
int fputc(int ch, FILE *f)
{
	while (USART_GetFlagStatus(USART1, USART_FLAG_TXE) == RESET);
	USART_SendData(USART1, (uint8_t)ch);

	return ch;
}
