FlyRay2025-gif/stm32-env-thermometer/(commit log)

2026-10-17 Initial commit: STM32 环境温度测量仪（面包板整机）
    - STM32F103C8T6 + DS18B20 + LM35 双通道测温
    - OLED 显示 / 3 键阈值设置 / 蜂鸣器+LED 报警 / 串口 CSV
    - 标准外设库 V3.5.0 工程，附面包板接线图与方案文档
2026-10-17 docs: 补充实物照片（上电实测 DS18B20 21.54℃ / LM35 22.6℃）
